MZ-Shihab/Vehicle-Safety-and-Accident-Detection-System/Sample SMS Output.png

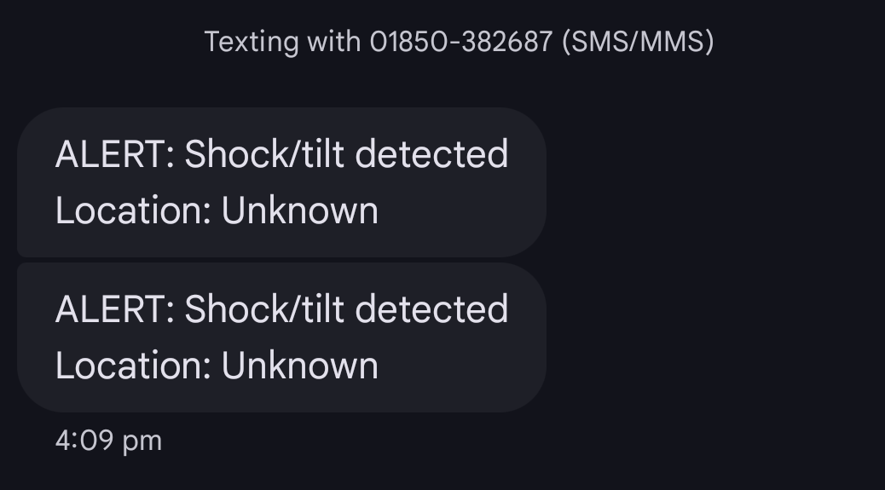
Sample SMS Output.png
