MZ-Shihab/Vehicle-Safety-and-Accident-Detection-System/Sample Telegram_Output1.jpg

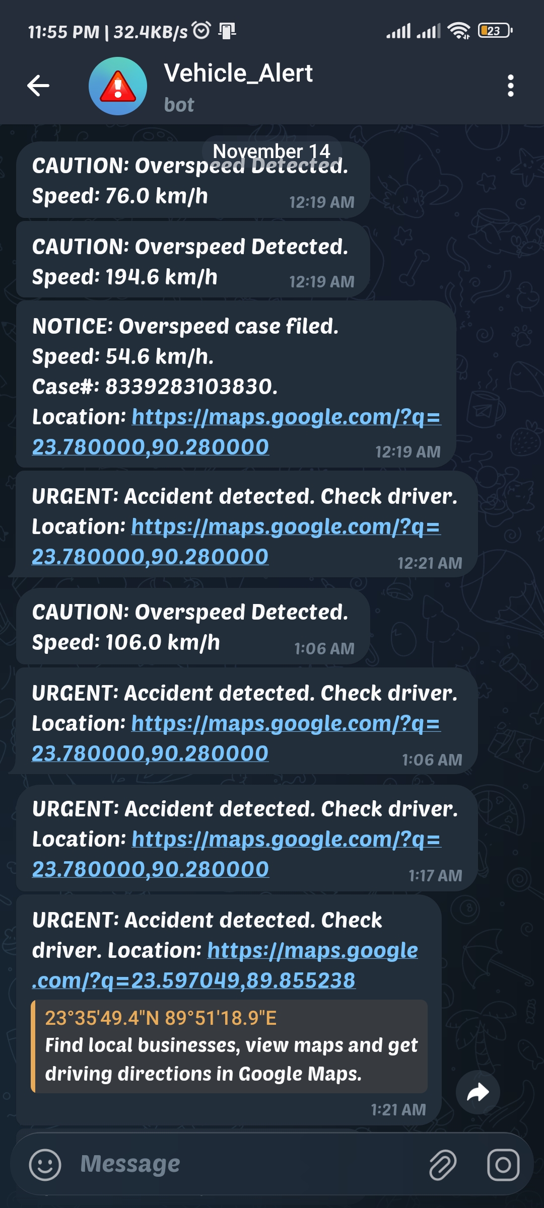
Sample Telegram_Output1.jpg
