MZ-Shihab/Vehicle-Safety-and-Accident-Detection-System/Sample Telegram_Output2.jpg

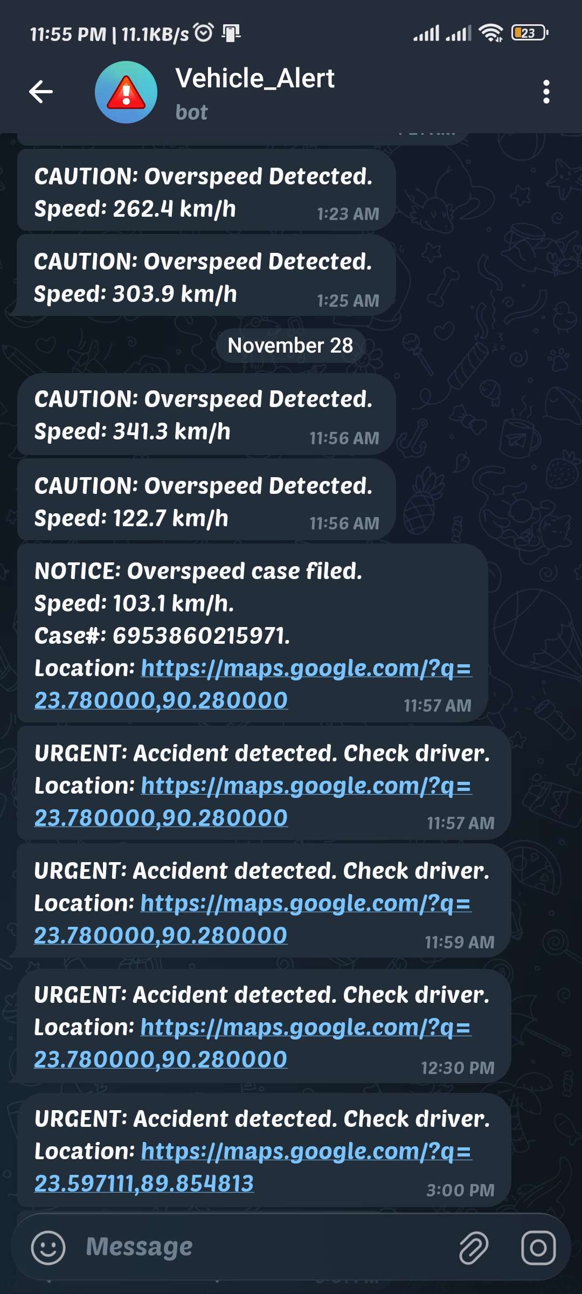
Sample Telegram_Output2.jpg
