MZ-Shihab/Vehicle-Safety-and-Accident-Detection-System/Schematic_Vehicle-Accident-Safety-Project-✅✅_2025-11-09.png

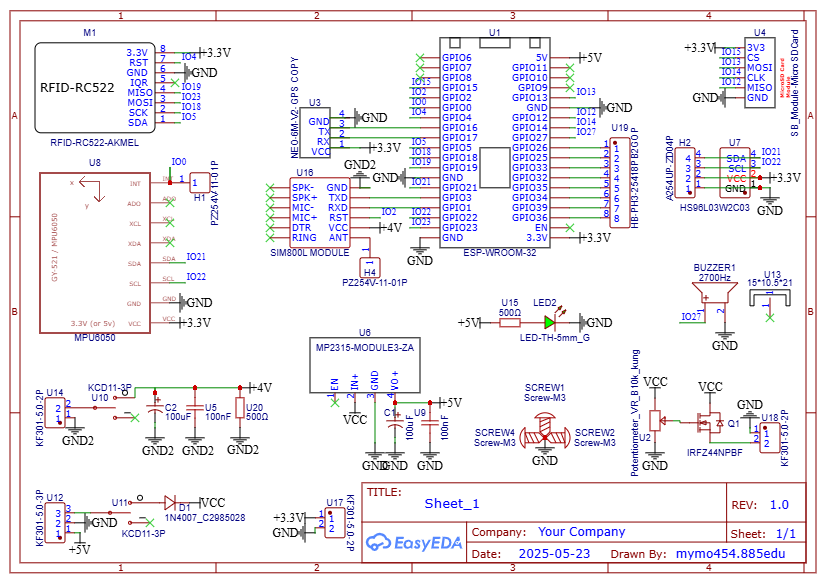
Schematic_Vehicle-Accident-Safety-Project-✅✅_2025-11-09.png
