MZ-Shihab/Vehicle-Safety-and-Accident-Detection-System/Working Flowchart.png

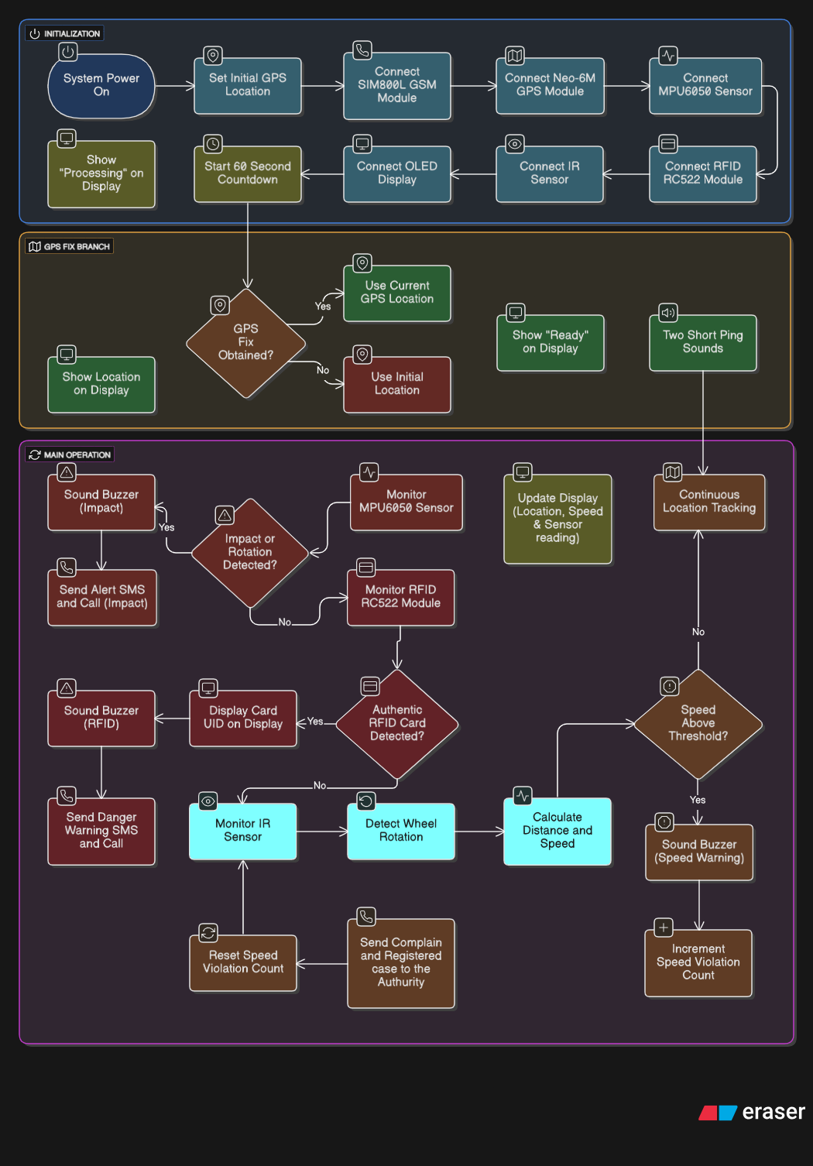
Working Flowchart.png
